dilithjay/AutonomousRobotCar/PC/LaneDetectionModule/images/4.jpg

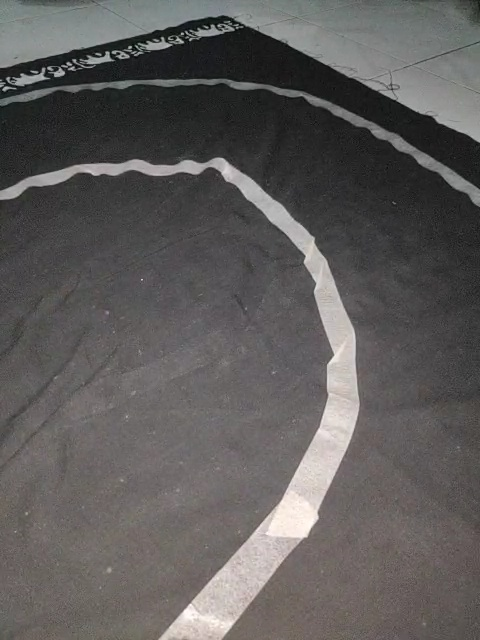
PC/LaneDetectionModule/images/4.jpg
