dilithjay/AutonomousRobotCar/PC/LaneDetectionModule/images/0.jpg

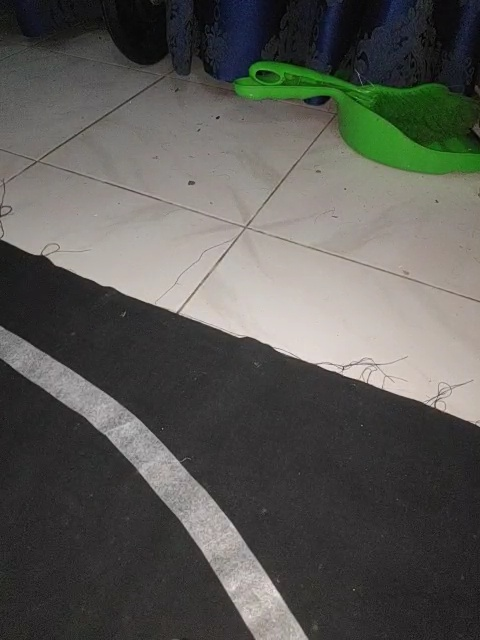
PC/LaneDetectionModule/images/0.jpg
