dilithjay/AutonomousRobotCar/PC/LaneDetectionModule/images/1.jpg

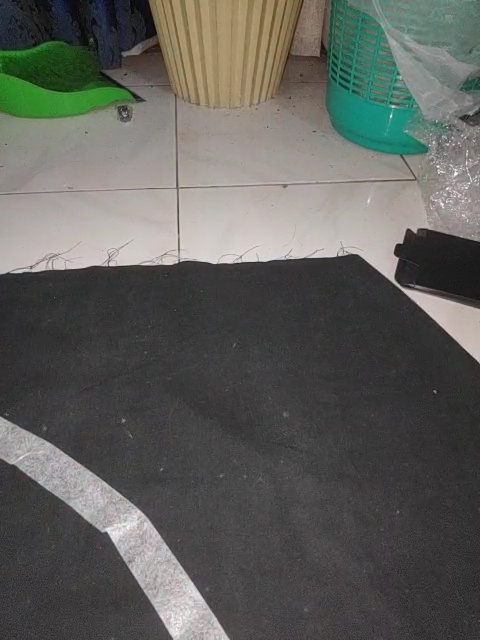
PC/LaneDetectionModule/images/1.jpg
