dilithjay/AutonomousRobotCar/PC/LaneDetectionModule/images/2.jpg

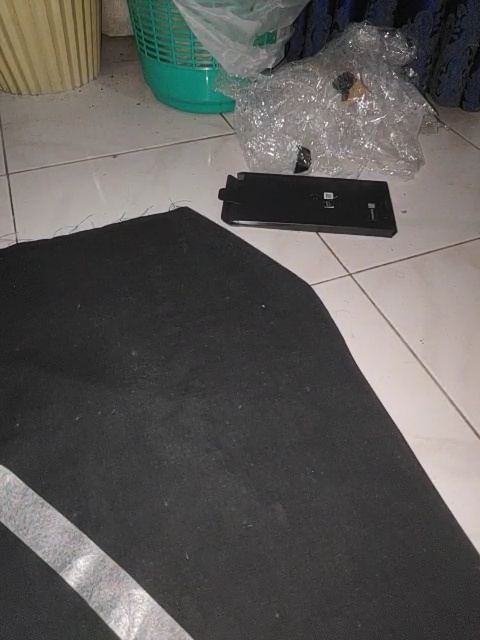
PC/LaneDetectionModule/images/2.jpg
