dilithjay/AutonomousRobotCar/PC/LaneDetectionModule/images/3.jpg

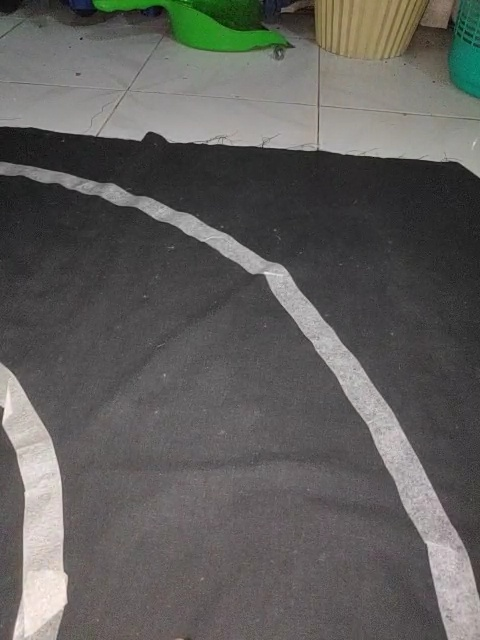
PC/LaneDetectionModule/images/3.jpg
