dilithjay/AutonomousRobotCar/PC/LaneDetectionModule/images/5.jpg

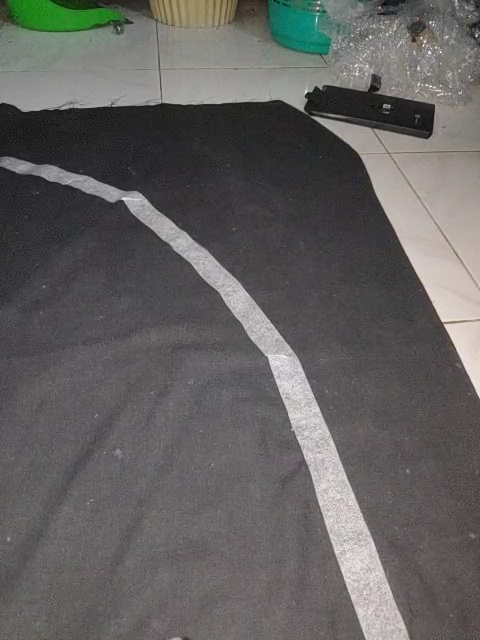
PC/LaneDetectionModule/images/5.jpg
