dilithjay/AutonomousRobotCar/Arduino/motor_control_with_encoder_fail_safe_bluetooth/motor_control_with_encoder_fail_safe_bluetooth.ino

#include "TimerOne.h"

// L298N motor driver control pins
const byte enA = 11;
const byte in1 = 9;
const byte in2 = 8;
const byte in3 = 7;
const byte in4 = 6;
const byte enB = 5;

// Variables for speed encoders
const byte encA = 3;
const byte encB = 2;
const float disk_slots = 20.0f;
const float wheel_diameter = 66.0f;
const float interval_secs = 5.0f;
volatile int counter_A = 0;
volatile int counter_B = 0;
float rpm_A = 0.0f, rpm_B = 0.0f;

// Ultrasonic Sensor Pins (3-wire mode)
const byte uss_left = 12;
const byte uss_mid = 10;
const byte uss_right = 4;

// Minimum distance for collision in centimeters
const byte threshold = 12;

byte left_speed, right_speed;
bool speed_received = false;

void ISR_count_A() {
  counter_A++;
}

void ISR_count_B() {
  counter_B++;
}

void ISR_timerone()
{
  Timer1.detachInterrupt();
  rpm_A = (counter_A / disk_slots) / interval_secs * 60.0f;
  counter_A = 0;
  rpm_B = (counter_B / disk_slots) / interval_secs * 60.0f;
  counter_B = 0;
  Timer1.attachInterrupt( ISR_timerone );
}

void setup() {
  // Define pin modes
  pinMode(enA, OUTPUT);
  pinMode(enB, OUTPUT);
  pinMode(in1, OUTPUT);
  pinMode(in2, OUTPUT);
  pinMode(in3, OUTPUT);
  pinMode(in4, OUTPUT);

  // Initialize Serial for printing results
  Serial.begin(9600);
  // Ensure Serial is ready
  while (! Serial);

  Timer1.initialize(interval_secs * 1000000.0f); // set timer for 1sec
  attachInterrupt(digitalPinToInterrupt (encA), ISR_count_A, RISING);
  attachInterrupt(digitalPinToInterrupt (encB), ISR_count_B, RISING);
  Timer1.attachInterrupt( ISR_timerone );
}

void loop() {
  // Check if any of the distances from the 3 ultrasonic sensors were below the threshold.
  if (getUltrasonicDistance(uss_mid) < threshold ||
      getUltrasonicDistance(uss_left) < threshold ||
      getUltrasonicDistance(uss_right) < threshold){
    stop_and_wait(5000);
    return;
  }


  if (Serial.available() == 2){
    left_speed = Serial.read();
    right_speed = Serial.read();
    // print_speeds();
    print_RPMs();
  }
  setLeftSpeed(left_speed);
  setRightSpeed(right_speed);
}

void stop_and_wait(int millisecs) {
  setLeftSpeed(0);
  setRightSpeed(0);
  delay(millisecs);
}

void setLeftSpeed(byte num) {
  analogWrite(enB, num);
  digitalWrite(in3, HIGH);
  digitalWrite(in4, LOW);
}

void setRightSpeed(byte num) {
  analogWrite(enA, num);
  digitalWrite(in1, HIGH);
  digitalWrite(in2, LOW);
}

// Calculate distance from ultrasonic sensor readings
int getUltrasonicDistance(int pin) {
  pinMode(pin, OUTPUT);
  digitalWrite(pin, HIGH);
  delay(20);
  digitalWrite(pin, LOW);
  pinMode(pin, INPUT);
  int result = pulseIn(pin, HIGH, (unsigned long)60000) / 29 / 2;
  // Serial.println(result);
  return result;
}

void print_RPMs() {
  Serial.print("M1: ");
  Serial.print(rpm_A);
  Serial.print(" - ");
  Serial.print("M2: ");
  Serial.println(rpm_B);
}

void print_speeds(){
  Serial.print("L: ");
  Serial.print(left_speed);
  Serial.print(", R: ");
  Serial.println(right_speed);
}
