dilithjay/AutonomousRobotCar/Arduino/hc05_bt_test/hc05_bt_test.ino

#define ledPin 7
int state = 0;
void setup(){
  pinMode(ledPin, OUTPUT);
  digitalWrite(ledPin, LOW);
  Serial.begin(9600);
}

void loop(){
  if (Serial.available() > 0){
    state = Serial.read();
    digitalWrite(ledPin, HIGH);
    Serial.println(state);
  }
  if (state == '0'){
    digitalWrite(ledPin, LOW);
    Serial.println("LED: OFF");
    state = 0;
  }
  else if (state == '1'){
    digitalWrite(ledPin, HIGH);
    Serial.println("LED: ON");
    state = 0;
  }
  delay(50);
}
