dilithjay/AutonomousRobotCar/(commit log)

2021-08-01 Created the base code for i2c and motor driver
2021-08-18 Added fail safe with ultrasonic sensors
2021-08-28 Fixed main program bugs on RPi
    [main_rpi.py]
2021-08-28 OSError handling for I2C
2021-08-28 Fixed main_rpi reset_speeds argument error
    [main_rpi.py]
2021-08-31 Calibrations from Raspberry Pi
2021-10-13 Switched from using PyBluez library to serial library for bluetooth.
2021-10-13 Added calibration offset for motor speeds.
2021-11-13 Added encoders and PID control.
2021-11-16 PID parameter tuning
